joydip09/HomeSafe/(commit log)

2026-10-21 Add sensor management functionality with Flame Sensor, PIR, DHT and MQ sensor support
2026-10-21 Add output management functionality with RGB LED and buzzer control
2026-10-28 Adjust ADC thresholds for MQ2 and MQ135 sensors to improve calibration accuracy
2026-10-28 Refactor: Comment out debug Serial prints for cleaner output
2026-10-29 Update default ADC thresholds for MQ-2 and MQ-135 sensors to improve calibration accuracy
